SHC-ASTRA/RoverElectronics/README.md

View this project on [CADLAB.io](https://cadlab.io/project/23863). 

# RoverElectronics
Electronics hardware for the full-scale rover
