SHC-ASTRA/RoverElectronics/main-board/main-board.kicad_pcb

## KiCad design main-board/main-board.kicad_pcb (2022-03-17)

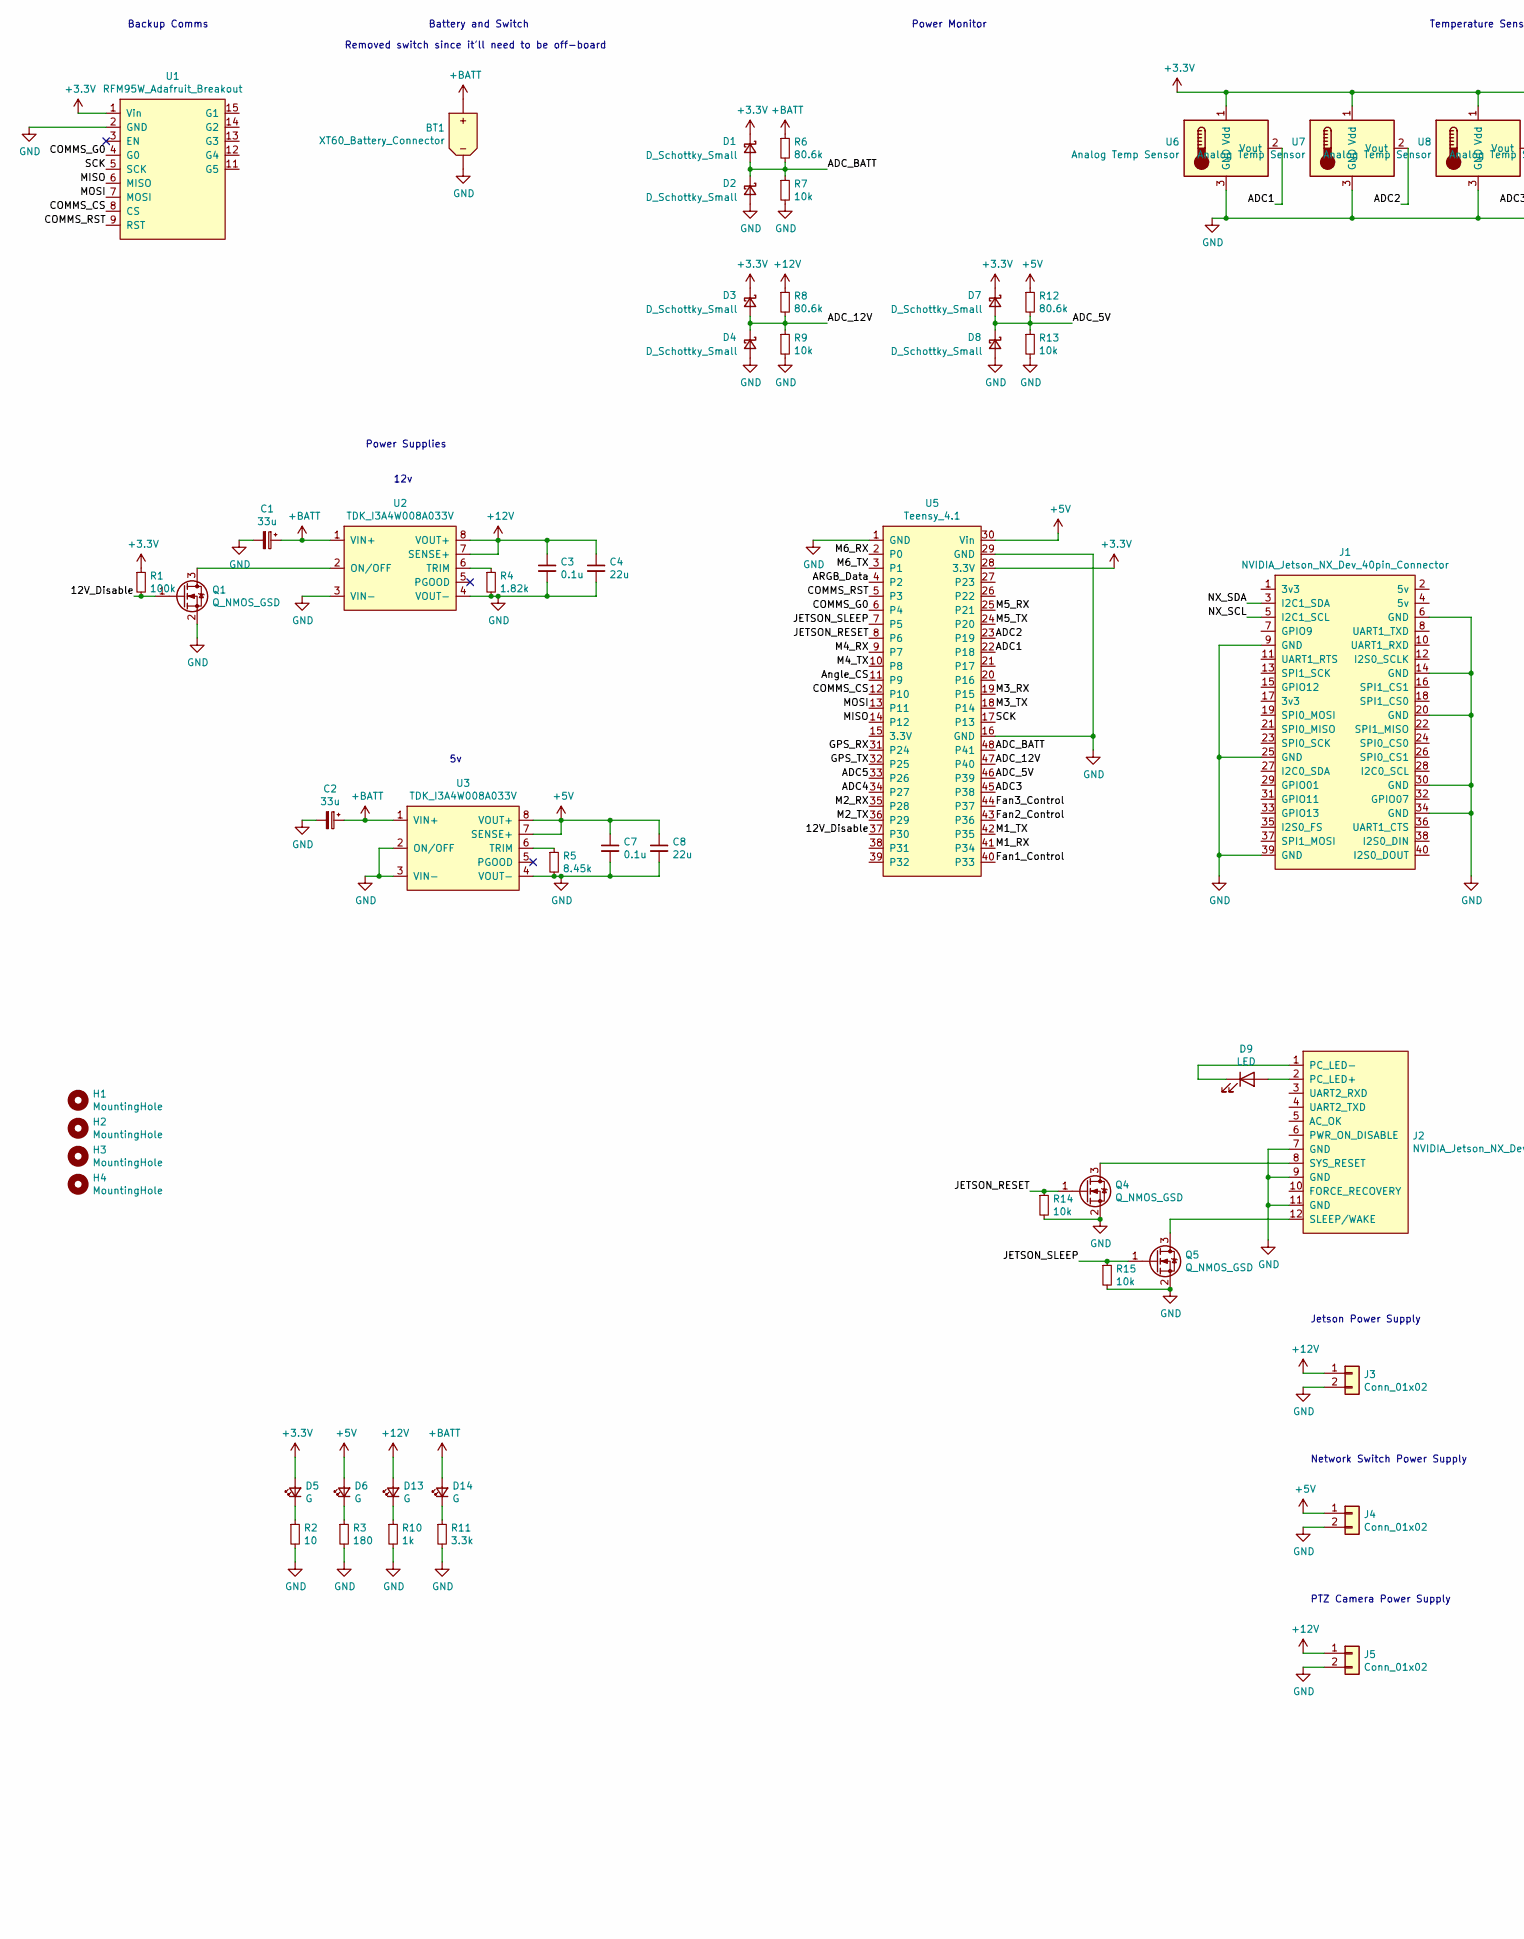
[picture p1: schematic main-board.sch, part in row 1, column 1]

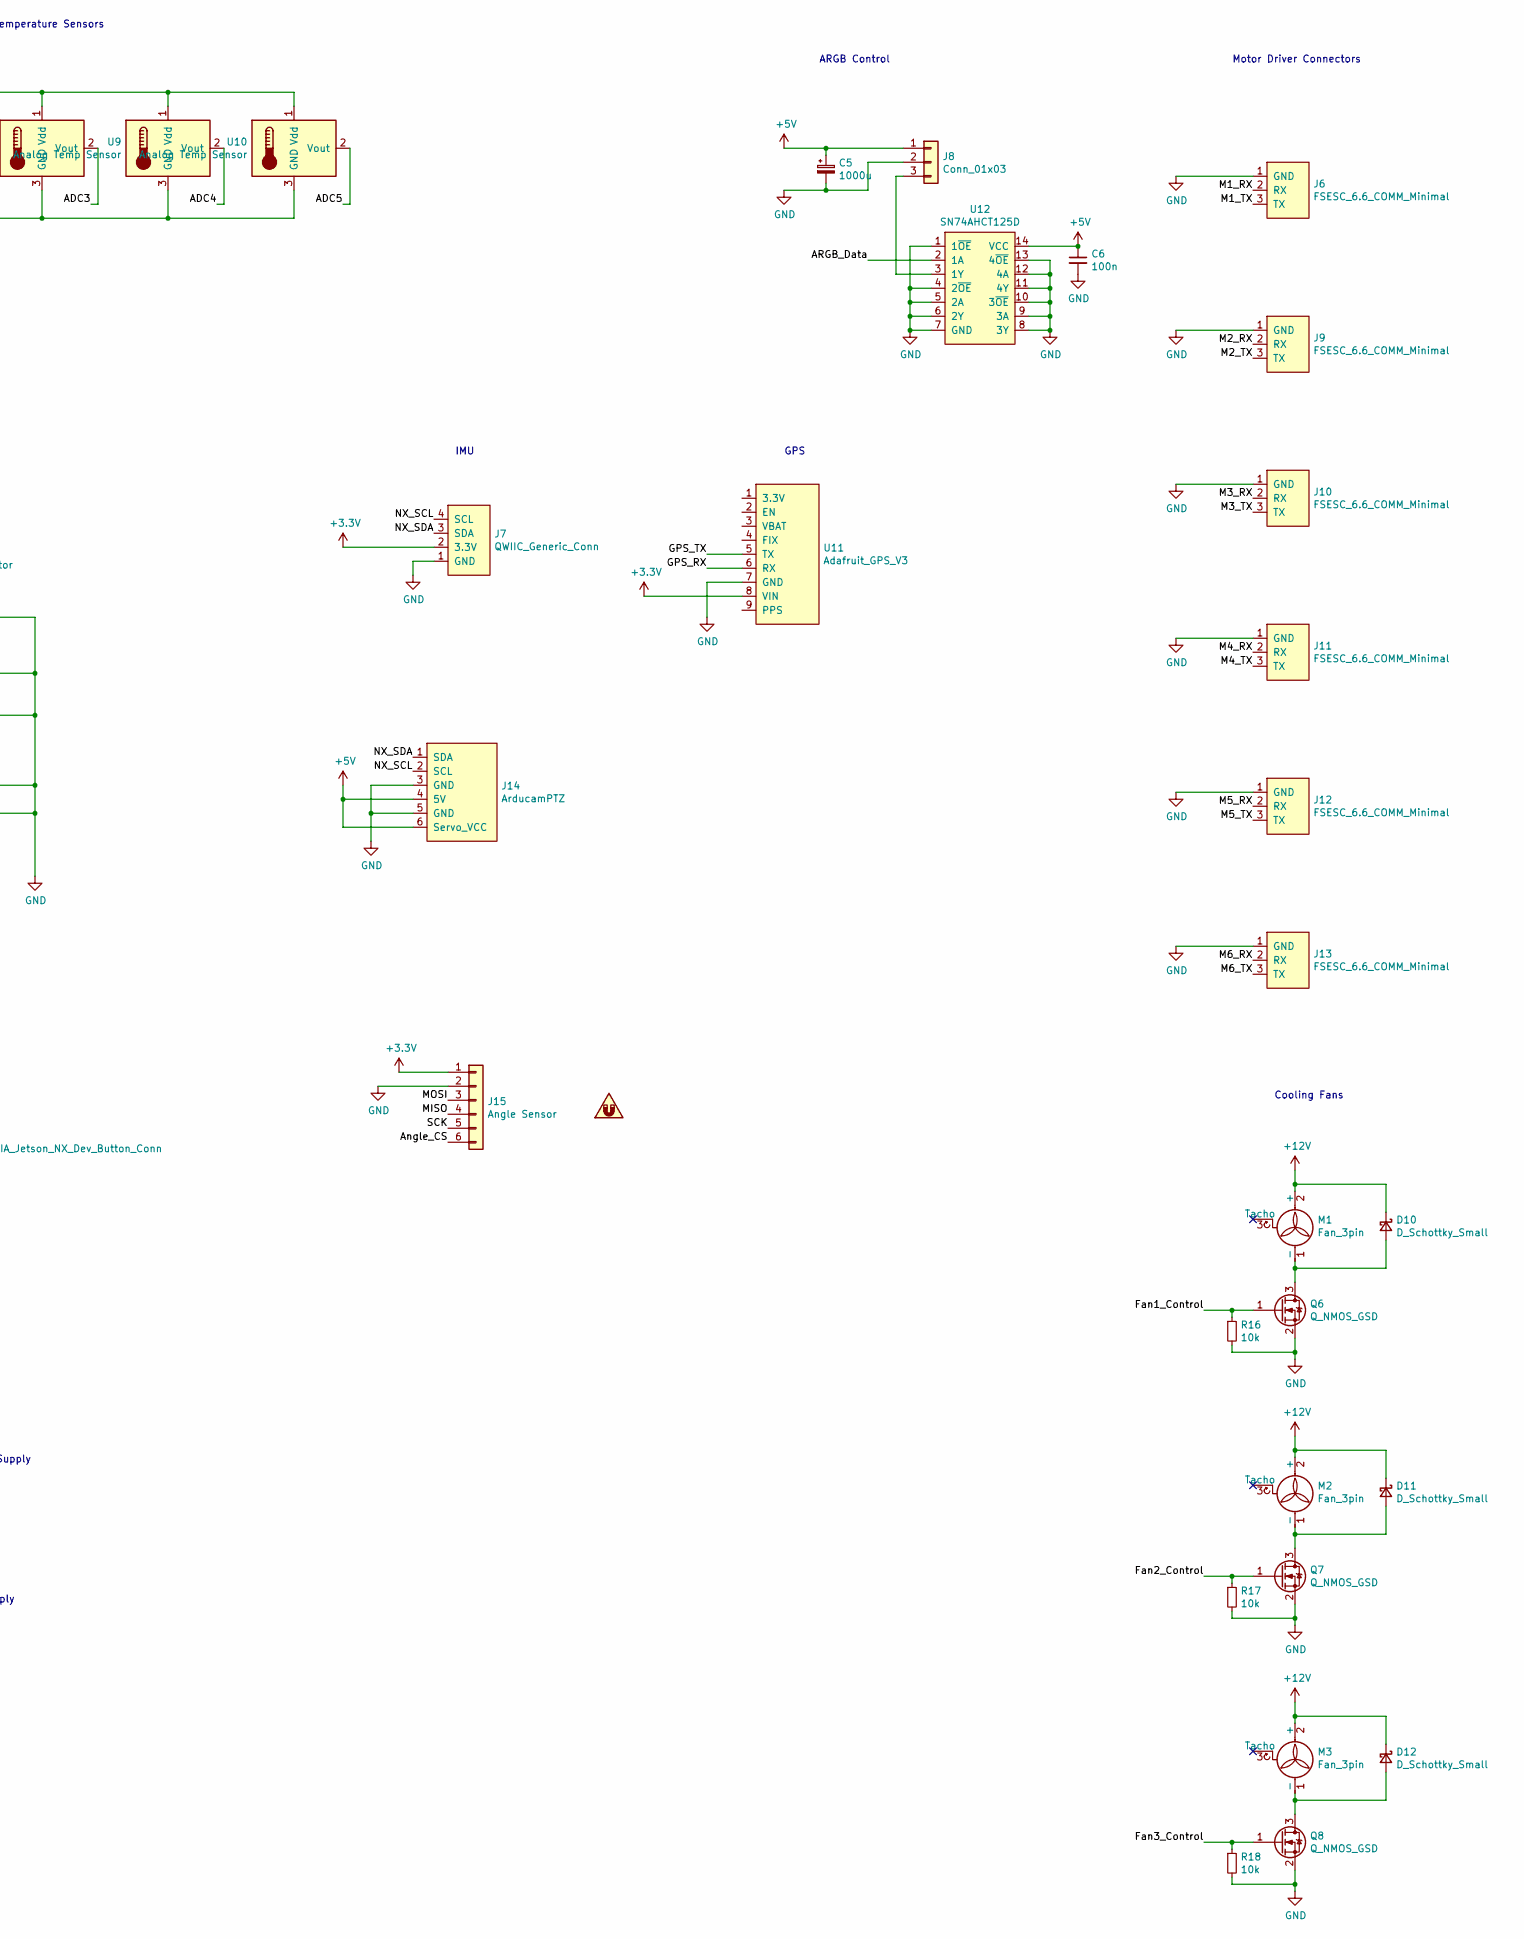
[picture p2: schematic main-board.sch, part in row 1, column 2]

Parts:
BT1: XT60_Battery_Connector; AMASS_XT60-M_1x02_P7.20mm_Vertical
C1, C2: 33u; CP_Elec_8x5.4; Digikey Part Num 493-2137-1-ND
C3, C7: 0.1u; C_0603_1608Metric
C4, C8: 22u; C_1210_3225Metric; Digikey Part Num 311-2053-1-ND
C5: 1000u; CP_Radial_D8.0mm_P3.50mm; Digikey Part Num 493-10756-1-ND
C6: 100n; C_0603_1608Metric; Digikey Part Num 1276-1941-1-ND
D1, D2, D3, D4, D7, D8: D_Schottky_Small; D_SOD-323_HandSoldering; Digikey Part Num 1514-CMDD6001TRPBFREECT-ND
D5, D6, D13, D14: G; LED_0603_1608Metric_Pad1.05x0.95mm_HandSolder; Digikey Part Num 732-4971-1-ND
D9: LED; LED_0603_1608Metric_Pad1.05x0.95mm_HandSolder; Digikey Part Num 732-4980-1-ND
D10, D11, D12: D_Schottky_Small; D_SOD-123F; Digikey Part Num 1655-1927-1-ND
H1, H2, H3, H4: MountingHole; MountingHole_3.2mm_M3_Pad
J1: NVIDIA_Jetson_NX_Dev_40pin_Connector; IDC-Header_2x20_P2.54mm_Vertical; Digikey Part Num S9175-ND
J2: NVIDIA_Jetson_NX_Dev_Button_Conn; PinHeader_1x12_P2.54mm_Vertical
J3, J4, J5: Conn_01x02; JST_XH_B2B-XH-A_1x02_P2.50mm_Vertical; Digikey Part Num 455-2247-ND
J6, J9, J10, J11, J12, J13: FSESC_6.6_COMM_Minimal; JST_PH_B3B-PH-K_1x03_P2.00mm_Vertical
J7: QWIIC_Generic_Conn; JST_SH_SM04B-SRSS-TB_1x04-1MP_P1.00mm_Horizontal; Digikey Part Num 455-1804-1-ND
J8: Conn_01x03; JST_PH_B3B-PH-K_1x03_P2.00mm_Vertical; Digikey Part Num ~ JST PH
J14: ArducamPTZ; JST_XH_B6B-XH-A_1x06_P2.50mm_Vertical
J15: Angle Sensor; JST_PH_B6B-PH-K_1x06_P2.00mm_Vertical
M1, M2, M3: Fan_3pin; Molex_KK-254_AE-6410-03A_1x03_P2.54mm_Vertical; Digikey Part Num WM2701-ND
Q1, Q4, Q5, Q6, Q7, Q8: Q_NMOS_GSD; SOT-23; Digikey Part Num SSM3K2615RLFCT-ND
R1: 100k; R_0603_1608Metric; Digikey Part Num 311-100KHRCT-ND
R2: 10; R_0603_1608Metric; Digikey Part Num 311-10.0HRCT-ND
R3: 180; R_0603_1608Metric; Digikey Part Num 311-180HRCT-ND
R4: 1.82k; R_0603_1608Metric; Digikey Part Num 311-1.82KHRCT-ND
R5: 8.45k; R_0603_1608Metric; Digikey Part Num 311-8.45KHRCT-ND
R6, R8, R12: 80.6k; R_0603_1608Metric; Digikey Part Num P20500CT-ND
R7, R9, R13, R14, R15, R16, R17, R18: 10k; R_0603_1608Metric; Digikey Part Num 311-10.0KHRCT-ND
R10: 1k; R_0603_1608Metric; Digikey Part Num 311-1.00KHRCT-ND
R11: 3.3k; R_0603_1608Metric; Digikey Part Num 311-3.30KHRCT-ND
SYM1: SYM_Magnet_Small; Digikey Part Num 469-1025-ND
U1: RFM95W_Adafruit_Breakout; Adafruit_RFM95W; Digikey Part Num 1528-1667-ND
U2, U3: TDK_I3A4W008A033V; Power_Supply_32nd_Brick; Digikey Part Num 285-2720-ND
U5: Teensy_4.1; Teensy4.1; Digikey Part Num 1568-DEV-16771-ND
U6, U7: Analog Temp Sensor; TO-92; Digikey Part Num 296-46127-1-ND
U8, U9, U10: Analog Temp Sensor; JST_PH_B3B-PH-K_1x03_P2.00mm_Vertical; Digikey Part Num 296-46127-1-ND
U11: Adafruit_GPS_V3; Adafruit_GPS_Breakout; Digikey Part Num 1528-1153-ND
U12: SN74AHCT125D; SOIC-14_3.9x8.7mm_P1.27mm; Digikey Part Num 296-4652-5-ND

Connections:
+3V3: D1.1 (K), D3.1 (K), D5.2 (A), D7.1 (K), J7.2 (3.3V), J15.1, R1.1, U1.1 (Vin), U5.28 (3.3V), U6.1 (Vdd), U7.1 (Vdd), U8.1 (Vdd), U9.1 (Vdd), U10.1 (Vdd), U11.8 (VIN)
+5V: C5.1, C6.1, C7.1, C8.1, D6.2 (A), J4.1, J8.1, J14.4 (5V), J14.6 (Servo_VCC), R12.1, U3.7 (SENSE+), U3.8 (VOUT+), U5.30 (Vin), U12.14 (VCC)
+12V: C3.1, C4.1, D10.1 (K), D11.1 (K), D12.1 (K), D13.2 (A), J3.1, J5.1, M1.2 (+), M2.2 (+), M3.2 (+), R8.1, U2.7 (SENSE+), U2.8 (VOUT+)
+BATT: BT1.2 (Pos), C1.1, C2.1, D14.2 (A), R6.1, U2.1 (VIN+), U3.1 (VIN+)
/12V_Disable: Q1.1 (G), R1.2, U5.37 (P30)
/ADC1: U5.22 (P18), U6.2 (Vout)
/ADC2: U5.23 (P19), U7.2 (Vout)
/ADC3: U5.45 (P38), U8.2 (Vout)
/ADC4: U5.34 (P27), U9.2 (Vout)
/ADC5: U5.33 (P26), U10.2 (Vout)
/ADC_5V: D7.2 (A), D8.1 (K), R12.2, R13.1, U5.46 (P39)
/ADC_12V: D3.2 (A), D4.1 (K), R8.2, R9.1, U5.47 (P40)
/ADC_BATT: D1.2 (A), D2.1 (K), R6.2, R7.1, U5.48 (P41)
/ARGB_Data: U5.4 (P2), U12.2 (1A)
/Angle_CS: J15.6, U5.11 (P9)
/COMMS_CS: U1.8 (CS), U5.12 (P10)
/COMMS_G0: U1.4 (G0), U5.6 (P4)
/COMMS_RST: U1.9 (RST), U5.5 (P3)
/Fan1_Control: Q6.1 (G), R16.1, U5.40 (P33)
/Fan2_Control: Q7.1 (G), R17.1, U5.43 (P36)
/Fan3_Control: Q8.1 (G), R18.1, U5.44 (P37)
/GPS_RX: U5.31 (P24), U11.6 (RX)
/GPS_TX: U5.32 (P25), U11.5 (TX)
/JETSON_RESET: Q4.1 (G), R14.1, U5.8 (P6)
/JETSON_SLEEP: Q5.1 (G), R15.1, U5.7 (P5)
/M1_RX: J6.2 (RX), U5.41 (P34)
/M1_TX: J6.3 (TX), U5.42 (P35)
/M2_RX: J9.2 (RX), U5.35 (P28)
/M2_TX: J9.3 (TX), U5.36 (P29)
/M3_RX: J10.2 (RX), U5.19 (P15)
/M3_TX: J10.3 (TX), U5.18 (P14)
/M4_RX: J11.2 (RX), U5.9 (P7)
/M4_TX: J11.3 (TX), U5.10 (P8)
/M5_RX: J12.2 (RX), U5.25 (P21)
/M5_TX: J12.3 (TX), U5.24 (P20)
/M6_RX: J13.2 (RX), U5.2 (P0)
/M6_TX: J13.3 (TX), U5.3 (P1)
/MISO: J15.4, U1.6 (MISO), U5.14 (P12)
/MOSI: J15.3, U1.7 (MOSI), U5.13 (P11)
/NX_SCL: J1.5 (I2C1_SCL), J7.4 (SCL), J14.2 (SCL)
/NX_SDA: J1.3 (I2C1_SDA), J7.3 (SDA), J14.1 (SDA)
/SCK: J15.5, U1.5 (SCK), U5.17 (P13)
GND: BT1.1 (Neg), C1.2, C2.2, C3.2, C4.2, C5.2, C6.2, C7.2, C8.2, D2.2 (A), D4.2 (A), D8.2 (A), J1.6 (GND), J1.9 (GND), J1.14 (GND), J1.20 (GND), J1.25 (GND), J1.30 (GND), J1.34 (GND), J1.39 (GND), J2.7 (GND), J2.9 (GND), J2.11 (GND), J3.2, J4.2, J5.2, J6.1 (GND), J7.1 (GND), J8.2, J9.1 (GND), J10.1 (GND), J11.1 (GND), J12.1 (GND), J13.1 (GND), J14.3 (GND), J14.5 (GND), J15.2, Q1.2 (S), Q4.2 (S), Q5.2 (S), Q6.2 (S), Q7.2 (S), Q8.2 (S), R2.2, R3.2, R4.2, R5.2, R7.2, R9.2, R10.2, R11.2, R13.2, R14.2, R15.2, R16.2, R17.2, R18.2, U1.2 (GND), U2.3 (VIN-), U2.4 (VOUT-), U3.2 (ON/OFF), U3.3 (VIN-), U3.4 (VOUT-), U5.1 (GND), U5.16 (GND), U5.29 (GND), U6.3 (GND), U7.3 (GND), U8.3 (GND), U9.3 (GND), U10.3 (GND), U11.7 (GND), U12.1 (1~OE), U12.4 (2~OE), U12.5 (2A), U12.6 (2Y), U12.7 (GND), U12.8 (3Y), U12.9 (3A), U12.10 (3~OE), U12.11 (4Y), U12.12 (4A), U12.13 (4~OE)
unnamed: D5.1 (K), R2.1
unnamed: D6.1 (K), R3.1
unnamed: D9.1 (K), J2.1 (PC_LED-)
unnamed: D9.2 (A), J2.2 (PC_LED+)
unnamed: D10.2 (A), M1.1 (-), Q6.3 (D)
unnamed: D11.2 (A), M2.1 (-), Q7.3 (D)
unnamed: D12.2 (A), M3.1 (-), Q8.3 (D)
unnamed: D13.1 (K), R10.1
unnamed: D14.1 (K), R11.1
unnamed: J2.8 (SYS_RESET), Q4.3 (D)
unnamed: J2.12 (SLEEP/WAKE), Q5.3 (D)
unnamed: J8.3, U12.3 (1Y)
unnamed: Q1.3 (D), U2.2 (ON/OFF)
unnamed: R4.1, U2.6 (TRIM)
unnamed: R5.1, U3.6 (TRIM)

Notes on the sheet:
Power Supplies
Battery and Switch
Backup Comms
Power Monitor
Temperature Sensors
ARGB Control
Motor Driver Connectors
GPS
IMU
Cooling Fans
Jetson Power Supply
12v
Network Switch Power Supply
Removed switch since it'll need to be off-board
PTZ Camera Power Supply

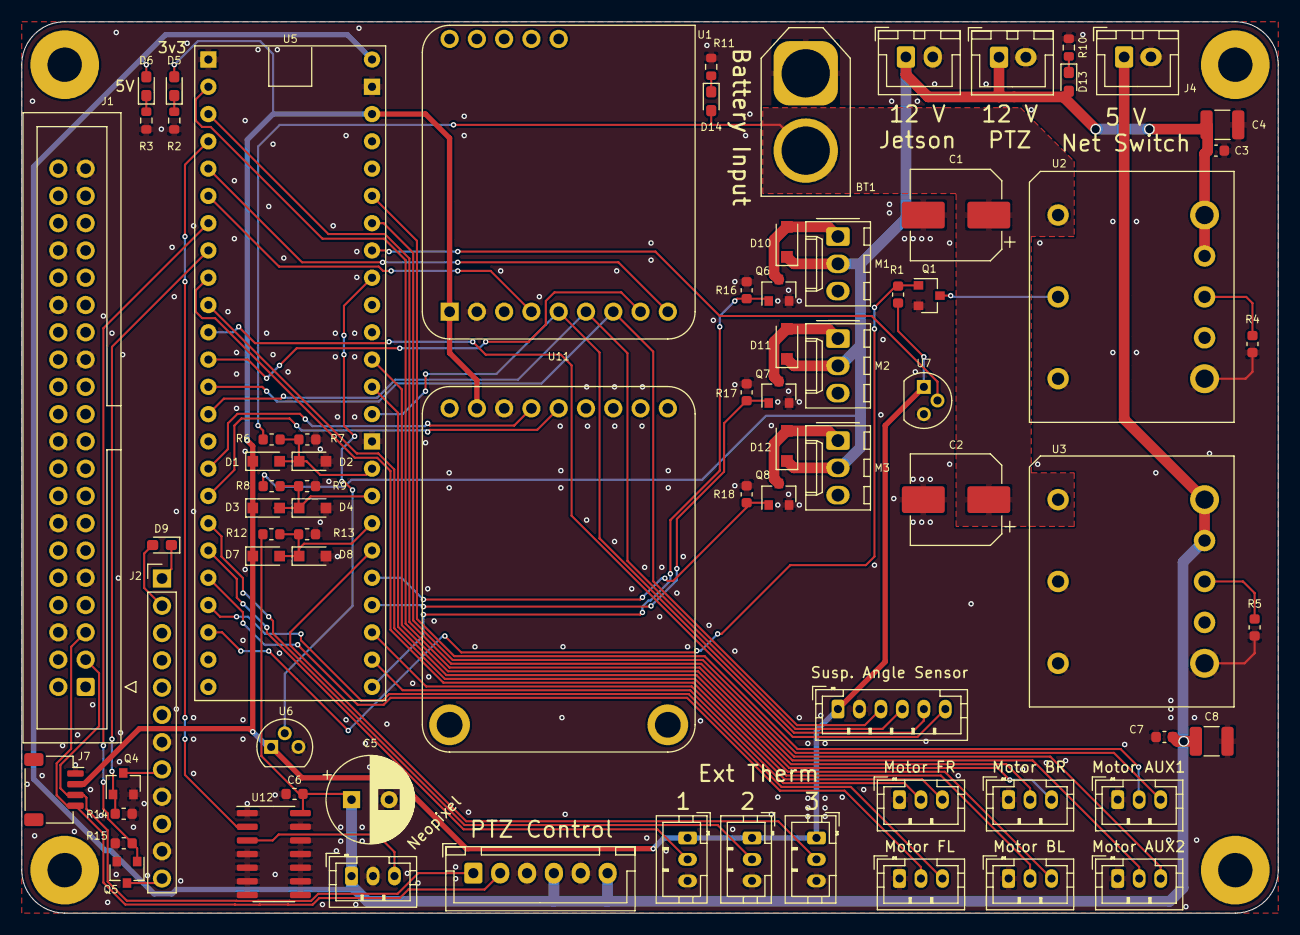
[picture p3: board main-board.kicad_pcb from above]

Board: 2 copper layers, 117.0 x 83.0 mm, 80 parts (0 on the bottom side), 58 nets.
