SHC-ASTRA/RoverElectronics/(commit log)

2021-02-10 Started KiCAD project
    [main-board.kicad_pcb, main-board.sch]
2021-04-13 Started filling out schematic
    [AuxiliaryController.sch, CoolingFan.sch, GPS.sch, Motor.sch, PrimaryController.sch, StatusLED.sch, example.sch, main-board.sch]
2021-04-13 Added a few more sheets
    Battery
    Jetson power button/LED
    Over-discharge protection
    OpenLog
    Power Supply
    [Battery.sch, CoolingFan.sch, GPS.sch, JetsonPower.sch, Motor.sch, ODP.sch, OpenLog.sch, PowerSupply.sch]
2021-04-19 More subsheets
    [AuxiliaryController.sch, BackupComms.sch, Battery.sch, CoolingFan.sch, GPS.sch, IMU.sch, JetsonPower.sch, Motor.sch]
2021-05-27 Subsheets
    Added motor drivers, cooling fans, and openlog
    [AuxiliaryController.sch, BackupComms.sch, Battery.sch, CoolingFan.sch, GPS.sch, IMU.sch, JetsonPower.sch, Motor.sch]
2021-05-27 More subsheets
    Added gps and LED ring
    [GPS.sch, StatusLED.sch]
2021-06-12 more subsheets
    backup coms
    [AuxiliaryController.sch, BackupComms.sch, Motor.sch, main-board.sch]
2021-06-12 Even more subsheets
    switched monitor and temp sensors to ADC. added temp sensors
    [PowerMonitor.sch, TempSensors.sch, main-board.sch]
2021-06-19 Added battery stuff
    [AuxiliaryController.sch, BackupComms.sch, Battery.sch, CoolingFan.sch, GPS.sch, IMU.sch, JetsonPower.sch, Motor.sch]
2021-06-26 removed battery protection (will be implemented off-board)
    [Battery.sch, battery-board.sch]
2021-07-24 Got rid of hierarchical sheets
    [BackupComms.sch, Battery.sch, CoolingFan.sch, GPS.sch, IMU.sch, JetsonPower.sch, Motor.sch, OpenLog.sch]
2021-07-27 Teensy Connections
    Added the majority of the teensy connections from the excel sheet (minus the coms). Added a few power connections
    [main-board.sch]
2021-07-31 changed a few thingies
    [main-board.sch]
2021-08-09 small tweaks
    [main-board.sch]
2021-08-09 started work on power supplies
    [main-board.sch]
2021-08-10 More work on power supply stuff
    [main-board.sch]
2021-08-10 Lots of small changes
    [main-board.sch]
2021-08-10 started sourcing components
    [main-board.sch]
2021-08-11 Parts selected
    [main-board.sch]
2021-08-11 Set a lot of footprints
    [AuxiliaryController.sch, BackupComms.sch, Battery.sch, CoolingFan.sch, GPS.sch, IMU.sch, JetsonPower.sch, Motor.sch]
2021-08-11 started PCB
    [main-board.kicad_pcb, main-board.sch]
2021-08-12 24v power supply swapped
    [main-board.kicad_pcb, main-board.sch]
2021-08-12 pcb layout attempt
    Tried to squish stuff together while still leaving room for traces (probably really rough)
    [main-board.kicad_pcb]
2021-08-12 fixed a small error with footprints
    [main-board.kicad_pcb, main-board.sch]
2021-08-12 ahhh i messed some stuff up
    [main-board.kicad_pcb]
2021-08-15 Removed 24V connector, Changed net switch power bus, changed motor driver connector
    [main-board.kicad_pcb, main-board.sch]
2021-08-28 Worked on PCB layout
    [main-board.kicad_pcb, main-board.sch]
2021-08-28 Started routing
    [main-board.kicad_pcb, main-board.sch]
2021-09-04 Shooouuulld be fully routed
    [main-board.kicad_pcb, main-board.sch]
2021-09-04 DONE! (hopefully)
    [main-board.kicad_pcb]
2021-09-20 Schematic layout done
    [main-board.kicad_pcb]
2021-09-21 XT60 Fix
    [main-board.kicad_pcb, main-board.sch]
2021-09-21 Probably should do a rev increase
    [main-board.kicad_pcb]
2022-03-14 Implemented post SAR fixes
    [main-board.kicad_pcb, main-board.sch]
2022-03-15 I changed something?
    [main-board.kicad_pcb]
2022-03-17 Indicator LEDs
    [main-board.kicad_pcb, main-board.sch]
